mathiaslec/open-lab-frame/README.md

# OpenLabFrame
Assembling instructions available here : https://mathiaslec.github.io/open-lab-frame/
