mathiaslec/open-lab-frame/cad/psu_control_box/dxf/psu_control_box.dxf

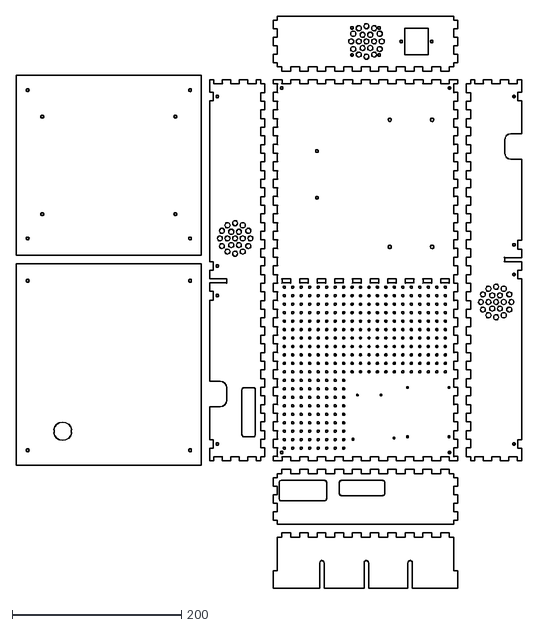
[picture p1: CAD file, 2022-02-10]
cad/psu_control_box/dxf/psu_control_box.dxf
596.0 x 675.0
