mathiaslec/open-lab-frame/gitbuilding/files/stl/M2_spacer.stl

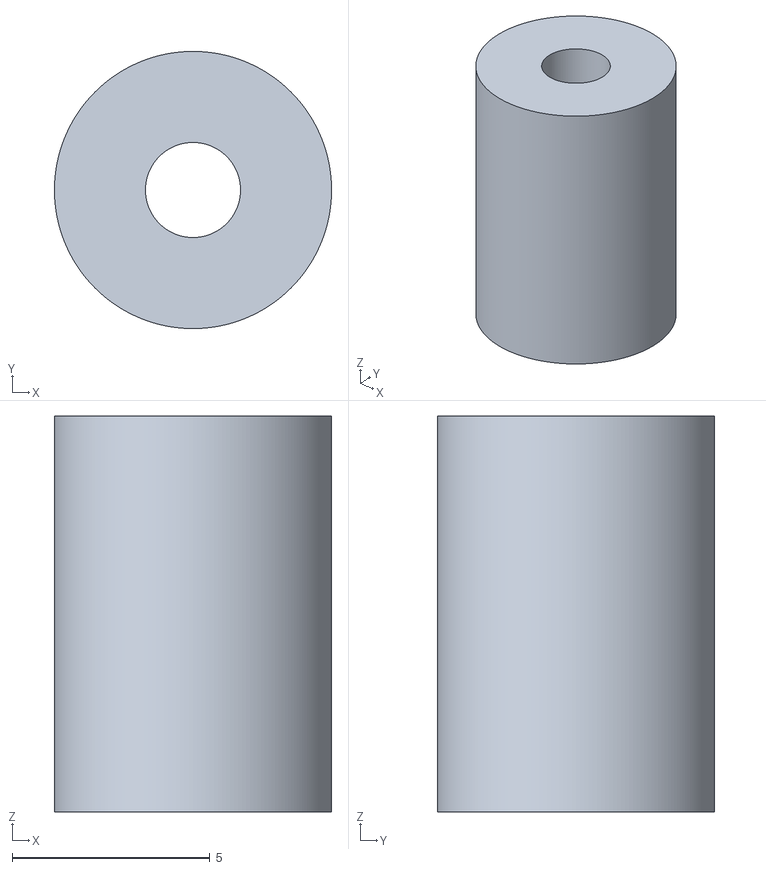
[picture p2: CAD file, 2022-02-15]
gitbuilding/files/stl/M2_spacer.stl
7.00 x 7.00 x 10.0
