mathiaslec/open-lab-frame/gitbuilding/files/stl/foot.stl

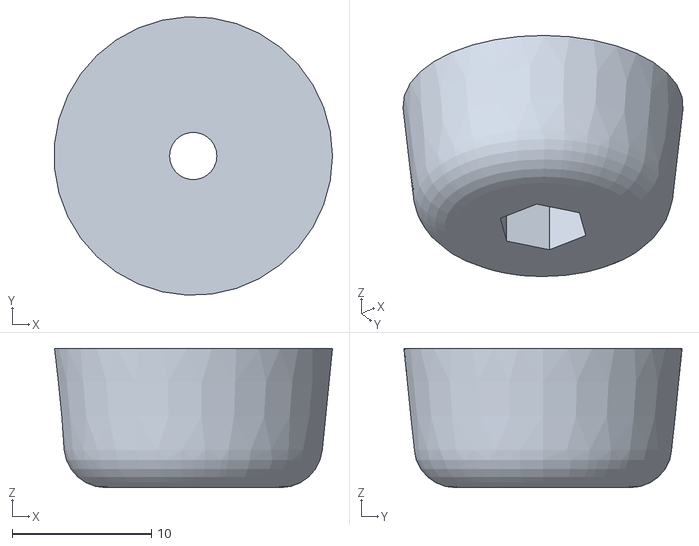
[picture p3: CAD file, 2022-02-15]
gitbuilding/files/stl/foot.stl
20.0 x 20.0 x 10.0
