mathiaslec/open-lab-frame/gitbuilding/files/stl/M3_spacer.stl

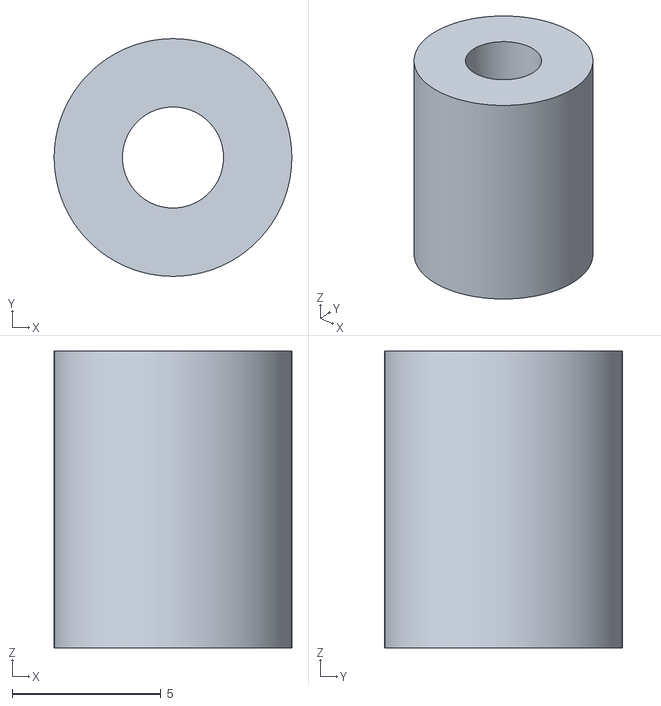
[picture p4: CAD file, 2022-02-15]
gitbuilding/files/stl/M3_spacer.stl
8.00 x 8.00 x 10.0
