mathiaslec/open-lab-frame/gitbuilding/files/stl/lid_attach.stl

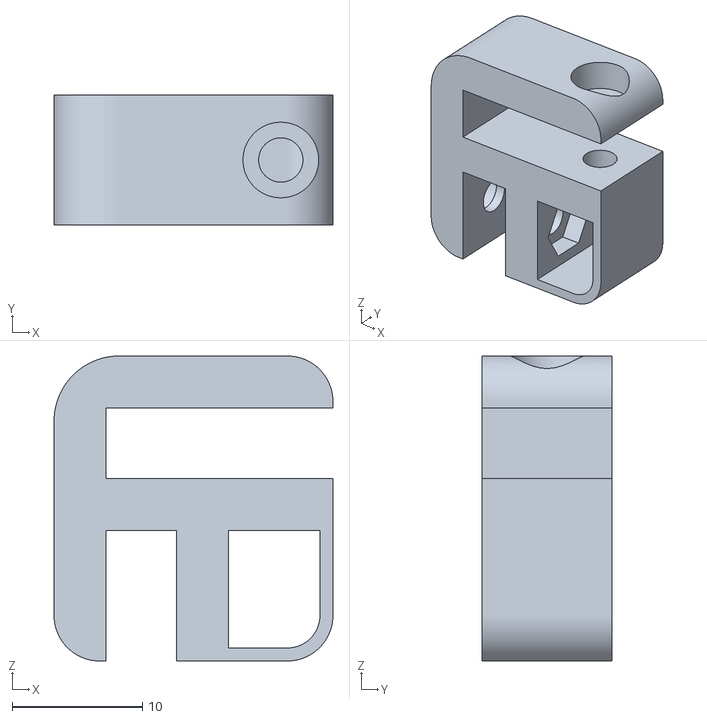
[picture p5: CAD file, 2022-02-15]
gitbuilding/files/stl/lid_attach.stl
21.4 x 10.0 x 23.4
