mathiaslec/open-lab-frame/gitbuilding/index.md

# Open Lab Frame  

Open Lab Frame is an open source project aiming at building modular and motorized/automated frames.  
Modular  = XYZ size of the frame + different heads (camera, pipette or anything else)  

You should link to a couple of pages:

* [Make the PSU & CTRL box](psu_control.md){step}
* [Update Arduino board & CNC shield](arduino_cncshield.md){step}

And you should definitely let people know about the [bill of materials]{BOM} page.
