mathiaslec/open-lab-frame/gitbuilding/images/cnc-shield_x-forward.png

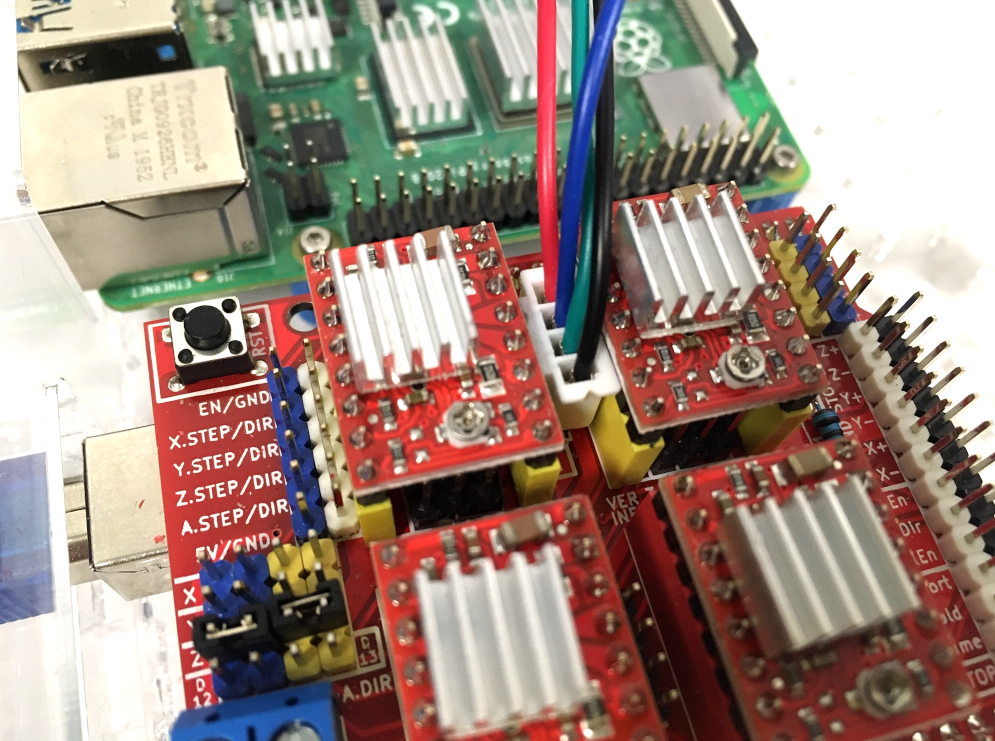
gitbuilding/images/cnc-shield_x-forward.png
