mathiaslec/open-lab-frame/gitbuilding/Parts.yaml

Multimeter:
    Name: Multimeter
    Suppliers:
        Conrad:
            PartNo: 124456
            Link: https://www.conrad.fr/p/multimetre-voltcraft-vc155-numerique-cat-iii-600-v-affichage-nombre-de-points-2000-124456

CrocodileClip:
    Name: Crocodile clips
    Suppliers:
        Conrad:
            PartNo: 1570584
            Link: https://www.conrad.fr/p/jeu-de-pinces-crocodiles-noir-rouge-blanc-vert-jaune-tru-components-93038c196-1409080-30-pcs-1570584

JumpersWires_FemaleMale:
    Name: Male/Female jumper wires
    Suppliers:
        Conrad:
            PartNo: 1221397
            Link: https://www.conrad.fr/p/mikroelektronika-mikroe-512-1-pcs-1221397

Jumpers:
    Name: Jumpers
    Suppliers:
        Conrad:
            PartNo: 737490
            Link: https://www.conrad.fr/p/shunt-ferme-fischer-elektronik-cab-4-g-s-pole2-pas-254-mm-noir-1-pcs-737490

StepperMotors:
    Name: Stepper motors (Nema 17)
    Description: > 
        The choice of the stepper motors depends on :  
          
        - The maximum power provided by the CNC shield and stepper drivers. As explained on Polulu page about A4988 drivers (https://www.pololu.com/product/1182),
        the maximum current/driver is 2A. Therefore there is no need to buy a stepper with higher nominal current.  
          
        - The holding torque needed. As an example, Creality printers have stepper motors with 0.4Nm; Prusa printers about 0.48Nm.  
    Specs:
        Torque: Minumum 0.4 Nm
        Type: Nema 17
    Suppliers:
        Conrad:
            PartNo: 2355876
            Link: https://www.conrad.fr/p/joy-it-moteur-pas-a-pas-nema17-06-059-nm-2-a-2-a-diametre-de-larbre-5-mm-2355876



TouchScreen:
    Name: Touch Screen
    Suppliers:
        Conrad:
            PartNo: 1503822
            Link: https://www.conrad.fr/p/module-ecran-tactile-joy-it-rb-lcd5-127-cm-5-pouces-800-x-480-pixel-convient-pour-raspberry-pi-avec-stylet-1-pcs-1503822

M3x10mm:
    Name: M3x10mm screws
    Suppliers:
        Conrad:
            PartNo: 1062107
            Link: https://www.conrad.fr/p/vis-cylindrique-toolcraft-1062107-100-pcs-m3-10-mm-tete-cylindrique-6-pans-interieurs-acier-inoxydable-na-1062107
EmergencyButton:
    Name: Emergency Button
    Suppliers:
        Conrad:
            PartNo: 1233789
            Link: https://www.conrad.fr/p/deca-a20b-v4e30r-arret-durgence-avec-element-de-contact-240-vac-6-a-3-no-t-ip65-1-pcs-1233789

Arduino:
    Name: Arduino board
    Suppliers:
        Conrad:
            PartNo: https://www.conrad.fr/p/carte-compatible-joy-it-arduino-uno-r3-dip-joy-it-atmega328-1-pcs-1456485
            Link: 1456485

CNCShield:
    Name: CNC Shield
    Suppliers:
        Conrad:
            PartNo: 1646889
            Link: https://www.conrad.fr/p/joy-it-ard-cnc-kit1-convient-pour-cartes-arduino-arduino-uno-1-pcs-1646889

CNCShieldWires:
    Name: Wires for CNC shield
    Suppliers:
        Conrad:
            PartNo:
            Link: 

RPiWires:
    Name: Wires to power RPi
    Suppliers:
        Conrad:
            PartNo: 1570820
            Link: https://www.conrad.fr/p/cordon-fil-a-carte-assemble-nombre-total-de-poles-2-741213-pas-254-mm-1-pcs-1570820

M2nut:
    Name: M2 nuts
    Suppliers:
        Conrad:
            PartNo: 888114
            Link: https://www.conrad.fr/p/toolcraft-888114-ecrou-hexagonal-m2-din-934-acier-inoxydable-a2-10-pcs-888114
M2x20mm: 
    Name: M2x20mm screws
    Suppliers:  
        Conrad:
            PartNo: 1790638
            Link: https://www.conrad.fr/p/toolcraft-to-5371914-vis-cylindrique-m2-20-mm-6-pans-interieurs-iso-4762-acier-inoxydable-a2-100-pcs-1790638
RPi:
    Name: RaspberryPi
    Suppliers:
        Conrad:
            PartNo: 2138863
            Link: https://www.conrad.fr/p/raspberry-pi-4-b-2-gb-4-x-15-ghz-2138863

crimpConn:
    Name: Crimp connectors
    Suppliers:
        Conrad:
            PartNo: 1661654
            Link: https://www.conrad.fr/p/tru-components-tc-6646616-assortiment-de-cosses-a-sertir-050-mm-150-mm-rouge-140-pcs-1661654

CNCCable:
    Name: Cable for CNC shield powering
    Suppliers:
        Conrad:
            PartNo: 1572357
            Link: https://www.conrad.fr/p/fil-de-cablage-liy-z-tru-components-sh1998c508-1572357-2-x-2-mm-rouge-noir-10-m-1572357

fan:
    Name: fan
    Suppliers:
        Conrad:
            PartNo: 2147488
            Link: https://www.conrad.fr/p/sunon-ventilateur-axial-5-vdc-1394-mh-l-x-l-x-h-40-x-40-x-10-mm-2147488

M3x18mm:
    Name: M3x18mm screws
    Suppliers:
        Conrad:
            PartNo: 1790655
            Link: https://www.conrad.fr/p/toolcraft-to-5371965-vis-cylindrique-m3-18-mm-6-pans-interieurs-iso-4762-acier-inoxydable-a2-100-pcs-1790655

ferrules:
    Name: Ferrules
    Suppliers:
        Conrad:
            PartNo: 1564522
            Link: https://www.conrad.fr/p/assortiment-dembouts-simples-tru-components-e400fs-739872-050-mm-250-mm-blanc-bleu-rouge-noir-gris-400-pcs-1564522

crimpingPliers:
    Name: Crimping pliers
    Suppliers:
        Conrad:
            PartNo: 844519
            Link: https://www.conrad.fr/p/bruder-mannesmann-m-1092-s-pince-a-sertir-pour-connecteurs-enfichables-isoles-15-a-6-mm-844519

yellow_cable:
    Name: Yellow/Green cable
    Suppliers:
        Conrad:
            PartNo: 1428446
            Link: https://www.conrad.fr/p/helukabel-200200gnge-fil-de-cablage-h07v-k-1-x-150-mm-jaune-vert-marchandise-vendue-au-metre-1428446
brown_cable:
    Name: Brown cable
    Suppliers:
        Conrad:
            PartNo: 1428445
            Link: https://www.conrad.fr/p/helukabel-200200bn-fil-de-cablage-h07v-k-1-x-150-mm-marron-marchandise-vendue-au-metre-1428445
blue_cable:
    Name: Blue cable
    Suppliers:
        Conrad:
            PartNo: 1524778
            Link: https://www.conrad.fr/p/helukabel-64125-fil-de-cablage-h07v2-k-1-x-150-mm-bleu-marchandise-vendue-au-metre-1524778

M4x10mm:
    Name: M4x10mm screws
    Suppliers:
        Conrad:
            PartNo: 839709
            Link: https://www.conrad.fr/p/vis-cylindrique-toolcraft-839709-100-pcs-m4-10-mm-tete-cylindrique-6-pans-interieurs-acier-inoxydable-na-839709

PSU2:
    Name: 2725-LM200-10B12-ND PSU
    Suppliers:
        Digikey:
            PartNo: 2725-LM200-10B12-ND
            Link: https://www.digikey.fr/fr/products/detail/mornsun-america-llc/LM200-10B12/13968702


M3x8mm:
    Name: M3x8mm screws
    Suppliers:
        Conrad:
            PartNo: 1061818
            Link: https://www.conrad.fr/p/vis-cylindrique-toolcraft-1061818-100-pcs-m3-8-mm-tete-cylindrique-6-pans-interieurs-acier-inoxydable-na-1061818

PSU1:
    Name: LM35-10D0512-10 PSU
    Suppliers:
        Digikey:
            PartNo: 2725-LM35-10D0512-10-ND
            Link: https://www.digikey.fr/fr/products/detail/mornsun-america-llc/LM35-10D0512-10/13968639

M3nut:
    Name: M3 nuts
    Suppliers:
        Conrad: 
            PartNo: 131880
            Link: https://www.conrad.fr/p/toolcraft-131880-ecrou-hexagonal-m3-din-934-acier-100-pcs-131880

MaskingTape:
    Name: Masking tape
    Suppliers:
        Conrad: 
            PartNo: 2266109
            Link: https://www.conrad.fr/p/3m-5011850-5011850-ruban-de-masquage-beige-l-x-l-50-m-x-18-mm-1-pcs-2266109

AcrylicGlue:
    Name: Acrylic glue
    Suppliers:
        Conrad:
            PartNo: 539813
            Link: https://www.conrad.fr/p/adhesif-pour-verre-acrylique-539813-100-g-539813

PMMAsheet:
    Name: 5 mm PMMA sheet
    Description:
    Specs:
        Thickness: 5 mm
        Length: 500 mm
        Width: 500 mm
    Suppliers:
        Polydis: 
            PartNo: PMAGS505
            Link: https://www.polydis.fr/pmma-coule-incolore-500x500x5-mm-c2x30047366
        A4:
            PartNo: PLMXT-5-500X500-TS
            Link: https://www.a4.fr/pmma-extrude-transparent-5-500-x-500.html

M4x10PanSteel:
    Name: M4x10 Pan Head Steel
    Description: >
        This is lots of text
        about some screws?
    Specs:
        Head: Pan
        Length: 10 mm
        Material: Stainless Steel
        Pitch: 0.7
    Suppliers:
        RS:
            PartNo: 528-817
            Link: https://uk.rs-online.com/web/p/machine-screws/0528817/
        McMasterCarr:
            PartNo: 90116A207
            Link: https://www.mcmaster.com/90116A207

LaserCutter:
    Name: 60W CO2 laser cutter
    Description:
    Suppliers: 
        Jamp78: 
            PartNo: JA55
            Link: http://www.jamp78.fr/


Screwdriverset:
    Name: Screwdriver
    Suppliers:
        Conrad:
            PartNo: 1761193
            Link: https://www.conrad.fr/p/jeu-de-tournevis-stanley-by-black-decker-35-pieces-1761193
