mathiaslec/open-lab-frame/(commit log)

2022-01-17 gh-page settings
    [index_BOM.csv]
2022-02-10 started writing
    [psu_control_box.dxf, todelete.stl]
2022-02-15 add gitbuilding text for PSU CTRL box
    [M2_spacer.stl, M3_spacer.stl, foot.stl, lid_attach.stl]
2022-02-16 add new page.md in gitbuilding: arduino_cncshield
2022-02-17 added part in arduino_cnc-shield md file
2022-02-18 new text on arduino_cncshield.md
    [todelete.stl]
2022-02-18 Add custom category for the test connectors
